wangjun0710/bloodhound/alph/bh_gprs_0_alph/调试记录.txt

1.SIM900适当左移，便于焊接；
2.470电容封装小了；
3.R2换成4.7K,R3换成47K
4.铜皮引出去后在拉一块儿，便于焊接；
5.R8\R9\R10\R11全部为4.3K
6.R1 = 1K
7.不能用RTR020P02，应该选用N沟道MOS，KI2302DS
8.SIM卡封装和引脚定义错了
  1-》6,2-》5,3—>4
