wangjun0710/bloodhound/beta/trans borad/bh_netlan_0_alph/电路设计说明.txt

                 硬件设计说明
1.模块功耗设计：禁用ZLAN1003芯片内部稳压电路，采用外部双电源供电，降低芯片运行温度；
2.模块传输速率设计：焊接R14，模块为高速运行状态，波特率最高可达115200,功耗相应增加。
  焊接R13，模块为低速运行状态，波特率最高可达57600，功耗相应较低。
3.外部供电尽量增加一个大的滤波电容；
4.485_TEN引脚作为外部485芯片控制引脚，根据需要选用；
5.模块复位可以按键复位（RST），也可使用外部连接单片机进行复位；
6.模块具备恢复默认设置按键（DEF），用于用户忘记IP地址的情况；
  （默认IP192.168.1.254，静态IP模式，255.255.255.0的网关，192.168.1.1的网关）
7.以太网接口电路布线通讯线采用差分布线方式
8.电源线尽可能粗，提供较强的网络驱动能力
