wangjun0710/bloodhound/alph/bh_carrier_0_alph/bh_carrier_0_alph.xls

Comment | Description | Designator | Footprint | LibRef | Quantity
10uf/6.3V | SMD-CAP | C1, C10 | C0603 | CAP-SMD | 2 | 100个4元 |  | 4 | 100
10uF | SMD-CAP | C2,C132,C142 | C0603 | CAP-SMD | 3 | 100个6元 |  | 6 | 100
0.1uf | SMD-CAP | C3, C4, C8, C9, C12, C14, C15, C16, C17, C18, C20, C24, C25, C27, C29, C31 | C0603 | CAP-SMD | 16 | 100个4元 |  | 4 | 100
4.7uf/6.3V | SMD-CAP | C5 | C0603 | CAP-SMD | 1 | 100个6元 |  | 6 | 100
1uF | SMD-CAP | C6 | C0603 | CAP-SMD | 1 | 100个4元 |  | 4 | 100
22uF/16V | SMD-CAP | C7 | C0603 | CAP-SMD | 1 | 50个8元 |  | 8 | 50
22pf | SMD-CAP | C11, C13, C19, C21, C22, C23, C26, C28 | C0603 | CAP-SMD | 8 | 100个4元 |  | 4 | 100
0.1u | SMD-CAP | C30 | C0603 | CAP-SMD | 1 | 100个4元 |  | 4 | 100
LED-RED | LED-SMD | D1 | D0805 | LED | 1 | 50个6元 |  | 6 | 50
LED-GREEN | LED-SMD | D2, D4 | D0805 | LED | 2 | 50个6元 |  | 6 | 50
SM340A | Schottky Diode | D3 | DO-214 | DIODE SCHOTTKY | 1 | 10个5元 |  | 5 | 10
IN4148 | IN4148 | D5 | D1206 | DIODE | 1 | 10个2元 |  | 2 | 10
HOL | Generic Antenna | HO1, HO2, HO3, HO4 | HOLE1 | Antenna | 4 | 提供图片 | 不购买，该项为定位孔
Battery Connector | XH-2.54-2P,弯角 | J1 | XH-2.54-2P | SIP1X2 | 1 | 0.24/PCS |  | 1.2 | 5
Solar Connetcor | XH-2.54-2P,弯角 | J2 | XH-2.54-2P | SIP1X2 | 1 | 0.24/PCS |  | 1.2 | 5
GPS_Socket-A | 单排排母2.54 | J4 | SIP1X5X2.54 | SIP1X5 | 1 | 0.5/PCS |  | 2.5 | 5
GPS_Socket-B | 单排排母2.54 | J5 | SIP1X5X2.54 | SIP1X5 | 1 | 0.5/PCS |  | 2.5 | 5
Sensor Connector | '双排排母2.54 | JP1 | SIP2X12X2.54 | SIP2X12 | 1 | 0.8/PCS |  | 4 | 5
Socket0-A | 单排排母2.54 | JP2 | SIP1x8x2.54 | SIP1X8 | 1 | 0.8/PCS |  | 4 | 5
Socket0-B | 单排排母2.54 | JP3 | SIP1x8x2.54 | SIP1X8 | 1 | 0.8/PCS |  | 4 | 5
Socket1-A | 单排排母2.0 | JP4 | SIP1x8x2.0 | SIP1X8 | 1 | 1.2/PCS |  | 6 | 5
Socket1B | 单排排母2.0 | JP5 | SIP1x8x2.0 | SIP1X8 | 1 | 1.2/PCS |  | 6 | 5
SPI/UART Connector | 单排排母2.54 | JP6 | SIP1x12x2.54 | SIP1X12 | 1 | 0.5/PCS |  | 2.5 | 5
KEY | 按钮2Pin | K1 | 3*6*2.5mm | KEY | 1 | 0.2/PCS |  | 1 | 5
1.5uH | LPS3015-152 | L1 | LPS3010 | L1 | 1 | 2/PCS |  | 10 | 5
INDUCTOR | 3.3uh | L2 | L1206 | INDUCTOR | 1 | 10个3元 |  | 3 | 10
USB | mricoUSB | P1 | MicroUSB_four | USB | 1 | 提供图片 | 不购买
JTAG | Header, 7-Pin, Dual row | P2 | SIP2X7X2.54 | Header 7X2 | 1 | 提供图片 | 不购买
9013 | NPN Transistor | Q1, Q2, Q5, Q6, Q7, Q8 | SOT-23 | NPN | 6 | 10个2元 |  | 6 | 30
RTR020P02 | P MOS | Q3, Q4, Q9, Q10, Q11, Q12 | TSMT3 | MOSFET P | 6 | 2/PCS |  | 60 | 30
10k | Resistor | R1, R2, R10, R11, R12, R13, R28, R30, R31, R32, R37, R39, R41, R42 | R0603 | RES | 14 | 100个3元 |  | 3 | 100
100k | Resistor | R3, R4, R15, R16, R17, R18 | R0603 | RES | 6 | 100个3元 |  | 3 | 100
1k | Resistor | R5, R6, R19, R20, R21, R22, R25 | R0603 | RES | 7 | 100个3元 |  | 3 | 100
1.66k 1% | Resistor | R7 | R0603 | RES | 1 | 100个3元 |  | 3 | 100
1M 1% | Resistor | R8 | R0603 | RES | 1 | 100个3元 |  | 3 | 100
1M 1% | Resistor | R9 | R0603 | RES | 1 | 100个3元 |  | 3 | 100
110k | Resistor | R14 | R0603 | RES | 1 | 100个3元 |  | 3 | 100
18k | Resistor | R23 | R0603 | RES | 1 | 100个3元 |  | 3 | 100
15k | Resistor | R24 | R0603 | RES | 1 | 100个3元 |  | 3 | 100
4.7k | Resistor | R26, R36 | R0603 | RES | 2 | 100个3元 |  | 3 | 100
0 | Resistor | R27, R29 | R0603 | RES | 2 | 100个3元 |  | 3 | 100
100 | Resistor | R33, R34 | R0603 | RES | 2 | 100个3元 |  | 3 | 100
2k | Resistor | R35 | R0603 | RES | 1 | 100个3元 |  | 3 | 100
51 | Resistor | R38, R40 | R0603 | RES | 2 | 100个3元 |  | 3 | 100
SD12D07VG3 | SD12D07VG3 | S1 | SW-1-2 | SW-SPDT | 1 | 0.4/PCS |  | 2 | 5
microSD | TF-CARD | SD1 | TF_CARD | microSD | 1 | 0.6/PCS | 图1 | 3 | 5
TPS63031 | IC | U1 | QFN-10 | TPS63031_2 | 1 | 12/PCS |  | 60 | 5
TP4057 | IC | U2 | SOT23-6 | PT4057 | 1 | 0.6/PCS |  | 3 | 5
FP6291 | IC | U3 | SOT23-6 | FP6291 | 1 | 1/PCS |  | 5 | 5
ADXL345 | IC | U4 | LGA-CC-14-1 | ADXL345 | 1 | 4/PCS |  | 20 | 5
DS3231S | IC | U5 | SO-16 | DS3231 | 1 | 10/PCS |  | 50 | 5
AT24C16 | EEROM | U6 | SO-8 | AT24C16 | 1 | 0.5/PCS |  | 2.5 | 5
MSP430F149 | MCU | U7 | LQFP64_M | MSP430F149 | 1 | 15/PCS |  | 75 | 5
PL2303 | IC | U8 | SOP28 | PL2303 | 1 | 2.5/PCS |  | 12.5 | 5
GM8125-SSO | IC | U9 | SOP-24 | GM8125 | 1 | 18/PCS |  | 90 | 5
LM1117-3.3V | IC | U52 | SOT-223 | LM1117 | 1 | 0.5/PCS |  | 2.5 | 5
8M | 晶振 | XT1 | HC-49S | XT | 1 | 0.4/PCS |  | 2 | 5
32.768K | 晶振 | XT2 | AT308 | XT | 1 | 0.4/PCS |  | 2 | 5
12M | 晶振 | XT3 | HC-49S | XT | 1 | 0.4/PCS |  | 2 | 5
12MHz | 晶振 | XT4 | HC-49S | XT | 1 | 0.4/PCS |  | 2 | 5
 |  |  |  |  |  |  | 总价 | 548.4
