wangjun0710/bloodhound/alph/bh_gprs_0_alph/bloodhound_gprs_0_alph.xls

Comment | Description | Designator | Footprint | LibRef | Quantity
470uf | 钽电容 | C1 | C6032 | CAP-T | 1 | 2/PCS |  | 10 | 5
0.1uF | SMD-CAP | C2, C4, C5, C6 | C0603 | CAP-SMD | 4 | 100个4元 |  | 4 | 100
22PF | SMD-CAP | C3 | C0603 | CAP-SMD | 1 | 100个4元 |  | 4 | 100
SS34 | Diode | D1, D2 | DO-214 | DIODE | 2 | 0.3/PCS |  | 3 | 10
D-SMBJ5.0CA | TVS | D3 | DO-214 | D-SMBJ5.0CA | 1 | 0.5/PCS |  | 2.5 | 5
LED GREEN | LED | DS1, DS2 | D0805 | LED | 2 | 50个6元 |  | 6 | 50
Socket1-A | 2.0排针，直角 | JP1 | SIP1x8x2.54 | SIP1X8 | 1 | 0.6/PCS |  | 3 | 5
Socket1-B | 2.0排针，直角 | JP2 | SIP1x8x2.54 | SIP1X8 | 1 | 0.6/PCS |  | 3 | 5
SMA-2 | IPX，接口 | P1 | IPX | BNC | 1 | 1/PCS | 图1 | 5 | 5
SMA-1 | SMB-KWE | P2 | SMA-2 | BNC | 1 | 3.5/PCS | 图2 | 17.5 | 5
9013 | NPN Transistor | Q1 | SOT23-3L | NPN | 1 | 10个2元 |  | 2 | 10
RTR020P02 | P MOSFET | Q2, Q3 | TSMT3 | MOSFET P | 2 | 2/PCS |  | 20 | 10
10k | Resistor | R1, R2, R3, R13 | R0603 | RES | 4 | 100个3元 |  | 3 | 100
22 | Resistor | R4, R5, R6 | R0603 | RES | 3 | 100个3元 |  | 3 | 100
1k | Resistor | R7, R8, R9, R10, R11 | R0603 | RES | 5 | 100个3元 |  | 3 | 100
0 | Resistor | R12, R14, R15, R16 | R0603 | RES | 4 | 100个3元 |  | 3 | 100
SIM | 手机SIM卡槽 | U1 | SIM | SIM | 1 | 2/PCS | 图3 | 10 | 5
SIM900A | GPRS | U2 | GSM_900A | SIM900 | 1 | 32/PCS |  | 160 | 5
SMF05C | TVS | U3 | SOT-363 | SMF05C | 1 | 1/PCS |  | 5 | 5
 |  |  |  |  |  |  | 总价 | 267
