wangjun0710/bloodhound/beta/application borad/bh_AI8&DI8_alph/bh_ai8&di8_alph.xls

Comment | Description | Designator | Footprint | LibRef | Quantity
10nF | SMD-CAP | C1, C2, C3, C4, C5, C6, C7, C8 | C0603 | CAP-SMD | 8
22uF/16V | SMD-CAP | C13 | C0805 | CAP-SMD | 1
0.1uF | SMD-CAP | C14, C15 | C0603 | CAP-SMD | 2
10uF/6.3V | SMD-CAP | C16 | C0805 | CAP-SMD | 1
SM340A | Schottky Diode | D1 | DO-214 | DIODE SCHOTTKY | 1
LED | 绿 | DS1, DS2, DS3, DS4, DS5, DS6, DS7, DS8 | D0805 | LED | 8
CON-2P-3.81 | 绿色3.81接线端子 | J1, J2 | CON10*0.381 | SIP1X10 | 10
4.7uH | Inductor | L1 | R1206 | INDUCTOR | 1
10k 1% | Resistor | R1, R2, R3, R4, R5, R6, R7, R8, R9, R10, R11, R12, R13, R14, R15, R16, R47 | R0603 | RES | 17
2k | Resistor | R17, R18, R19, R20, R21, R22, R23, R24, R25, R26, R27, R28, R29, R30, R31, R32 | R0603 | RES | 16
110k 1% | Resistor | R41 | R0603 | RES | 1
18k | Resistor | R42 | R0603 | RES | 1
1K | Resistor | R116, R119, R121, R123, R125, R127, R129, R131 | R0603 | RES | 8
250 %1 | Resistor | R117, R120, R122, R124, R126, R128, R130, R132 | R0603 | RES | 8
125 %1 | Resistor | R117, R120, R122, R124, R126, R128, R130, R132 | R0603 | RES | 8
LM358N | LM358N | U1, U2, U3, U4 | SO8NB | LM358N | 4
PC817 | PC817 | U5, U6, U7, U8, U9, U10, U11, U12 | SOP_4 | PC817*1 | 8
P521 | P521 | U5, U6, U7, U8, U9, U10, U11, U12 | SOP_4 | P521*1 | 8
FP6291 |  | U13 | SOT23-6 | FP6291 | 1
