wangjun0710/bloodhound/beta/trans borad/bh_rs485_0_alph/bh_rs485_0_alph.xls

Comment | Description | Designator | Footprint | LibRef | Quantity
CAP-SMD | SMD-CAP | C1 | C0603 | CAP-SMD | 1
DB9M | DM9母头，焊板，弯角 | J1 | DB9/M | DB9M | 1
RS485 | 接线端子3.98间距绿色 | J2 | CON2*0.381 | SIP1X2 | 1
Socket1-A | 排针2.0间距 | JP1 | SIP1x8x2.0 | SIP1X8 | 1
Socket1B | 排针2.0间距 | JP2 | SIP1x8x2.0 | SIP1X8 | 1
120 | Resistor | R1 | R0603 | RES | 1
0 | Resistor | R2, R3, R4, R5 | R0603 | RES | 4
MAX3485ESA | IC | U1 | SO-8 | MAX3485ESA | 1
