wangjun0710/bloodhound/beta/base borad/bloodhound_carrier_0_beta/调试记录.txt

2015/08/10
在alph版本上修复了如下功能：
1.DS3231封装错误，应该为SOP16 ok
2.建议调试口减小为6口，或者将接插件后退1mm  ok,后退了0.5mm
3.485子板的接口间距应该为26mm  ok
4.sd卡封装上的两个孔，孔洞太小 ok
5.reset信号未引线  OK
6.at24c16芯片采购的不能用，开发板的能用
7.不知道为什么，串口0的115200不能使用
8.8125串口线反了 ok
9.sensor板插上去后，JTAG口没法调试了

20150906
1.AD0原理图与PCB不符，AD0 PCB中无
