wangjun0710/bloodhound/alph/bh_carrier_0_alph/调试记录.txt

1.DS3231封装错误，应该为SOP16
2.建议调试口减小为6口，或者将接插件后退1mm
3.485子板的接口间距应该为26mm
4.sd卡封装上的两个孔，孔洞太小
5.reset信号未引线
6.at24c16芯片采购的不能用，开发板的能用
7.不知道为什么，串口0的115200不能使用
