wangjun0710/bloodhound/beta/application borad/bh_AI8&DI8_alph/调试记录.txt

1.R17-R20,R25-R28;换成<1K，或直接去掉；否则无法驱动光耦发出足够的光；
2.空载跟随器输入时，加一个100K的下拉电阻
