wangjun0710/bloodhound/beta/trans borad/bloodhound_gprs_0_beta/调试记录.txt

2015/0810
在alph版本上修复了如下功能：
1.SIM900适当左移，便于焊接；ok
2.470电容封装小了；  OK
3.R2换成4.7K,R3换成47K ok
4.铜皮引出去后在拉一块儿，便于焊接； ok
5.R8\R9\R10\R11全部为4.3K ok
6.R1 = 1K ok
7.不能用RTR020P02，应该选用N沟道MOS，KI2302DS ok
8.SIM卡封装和引脚定义错了 ok
  1-》6,2-》5,3—>4
9.直接用扩展口，去掉 ok
10.对角线加了两个定位孔
