wangjun0710/bloodhound/(list of files, drawings)

Other design files:
alph/bh_carrier_0_alph/bh_carrier_0_alph.PcbDoc
alph/bh_carrier_0_alph/bh_carrier_0_alph.PrjPcb
alph/bh_carrier_0_alph/bh_carrier_0_alph.SchDoc
alph/bh_gprs_0_alph/bloodhound_gprs_0_alph.PcbDoc
alph/bh_gprs_0_alph/bloodhound_gprs_0_alph.PrjPcb
alph/bh_gprs_0_alph/bloodhound_gprs_0_alph.SchDoc
alph/bh_rs485_0_alph/bh_rs485_0_alph.PcbDoc
alph/bh_rs485_0_alph/bh_rs485_0_alph.PrjPcb
beta/application borad/bh_AI8&DI8_alph/bh_ai8&di8_alph.PcbDoc
beta/application borad/bh_AI8&DI8_alph/bh_ai8&di8_alph.PrjPcb
beta/application borad/bh_AI8&DI8_alph/bh_ai8&di8_alph.SchDoc
beta/application borad/bh_AI8&DI8_alph/bh_ai8&di8_alph_back.PcbDoc
beta/application borad/bh_AI8&DI8_alph/bh_ai8&di8_alph_back.SchDoc
beta/application borad/bh_gateway_alph/bh_gateway_alph.PcbDoc
beta/application borad/bh_gateway_alph/bh_gateway_alph.PrjPcb
beta/application borad/bh_gateway_alph/bh_gateway_alph.SchDoc
beta/application borad/bh_sensor_argricultrue_alph/bh_sensor_argri_alph.PrjPcb
beta/application borad/bh_sensor_argricultrue_alph/bh_sensor_argri_alph.SchDoc
beta/base borad/bloodhound_carrier_0_beta/bh_carrier_0_beta.PcbDoc
beta/base borad/bloodhound_carrier_0_beta/bh_carrier_0_beta.PrjPcb
beta/base borad/bloodhound_carrier_0_beta/bh_carrier_0_beta.SchDoc
beta/base borad/bloodhound_carrier_0_beta/bh_carrier_0_beta_backup.PcbDoc
beta/trans borad/bh_netlan_0_alph/bh_netlan_0_alph.PcbDoc
beta/trans borad/bh_netlan_0_alph/bh_netlan_0_alph.PrjPcb
beta/trans borad/bh_netlan_0_alph/bh_netlan_0_alph.SchDoc
beta/trans borad/bh_rs485_0_alph/bh_rs485_0_alph.PcbDoc
beta/trans borad/bh_rs485_0_alph/bh_rs485_0_alph.PrjPcb
beta/trans borad/bh_rs485_0_alph/bh_rs485_0_alph.SchDoc
beta/trans borad/bloodhound_gprs_0_beta/bloodhound_gprs_0_beta.PcbDoc
beta/trans borad/bloodhound_gprs_0_beta/bloodhound_gprs_0_beta.PrjPcb
beta/trans borad/bloodhound_gprs_0_beta/bloodhound_gprs_0_beta.SchDoc
