wangjun0710/bloodhound/(commit log)

2015-06-28 init release for bloodhound
    carrier board,gprs board,rs485 board.
    [bh_carrier_0_alph.PcbDoc, bh_carrier_0_alph.PrjPcb, bh_carrier_0_alph.SchDoc, bh_carrier_0_alph.xls, bh_rs485_0_alph.PcbDoc, bh_rs485_0_alph.PrjPcb, bh_rs485_0_alph.SchDoc, bh_rs485_0_alph.xls]
2015-07-27 init
    bh_demo software iic spi gm8125 sd
2015-11-26 version clean up
    [bh_carrier_0_alph.PcbDoc, bh_carrier_0_alph.PrjPcb, bh_carrier_0_alph.SchDoc, bh_carrier_0_alph.xls, bh_rs485_0_alph.PcbDoc, bh_rs485_0_alph.PrjPcb, bh_rs485_0_alph.SchDoc, bh_rs485_0_alph.xls]
2015-11-26 beta version
    beta release
    [bh_ai8&di8_alph.PcbDoc, bh_ai8&di8_alph.PrjPcb, bh_ai8&di8_alph.SchDoc, bh_ai8&di8_alph.xls, bh_ai8&di8_alph_back.PcbDoc, bh_ai8&di8_alph_back.SchDoc, bh_carrier_0_beta.PcbDoc, bh_carrier_0_beta.PrjPcb]
